indigolemon/EZ-FD/README.md

# EZ-FD
Allow standard PC floppy drives to be used with an Amiga

A small PCB designed to sit between the Amiga motherboard and the floppy drive.
Based on the same idea as the EZ-DF0 that was sold by Eyetech many years ago.

Testing shows it works well, though ATK shows a fluctuating RDY signal.
