indigolemon/EZ-FD/EZ-FD_Raytraced.png

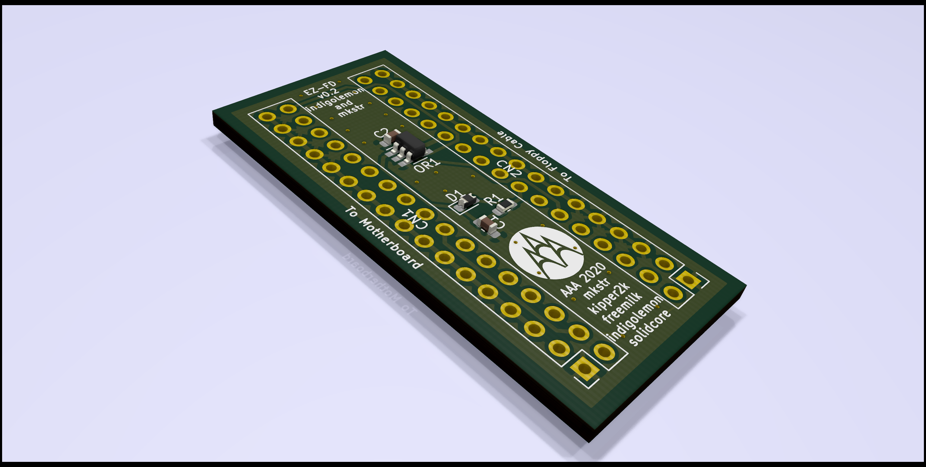
EZ-FD_Raytraced.png
