indigolemon/EZ-FD/EZ-FD.kicad_pcb

## KiCad design EZ-FD.kicad_pcb (2022-02-10)

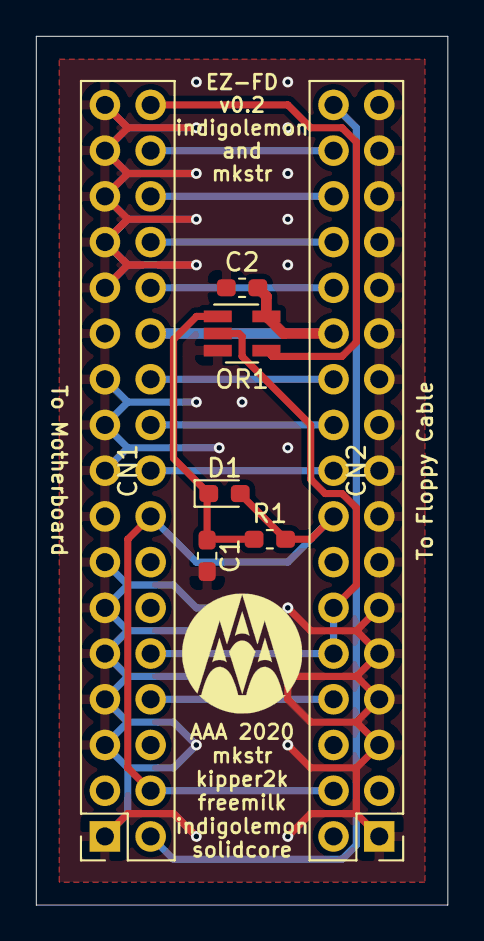
[picture p2: board EZ-FD.kicad_pcb from above]

Board: 2 copper layers, 22.9 x 48.3 mm, 7 parts (0 on the bottom side), 15 nets.

Parts:
C1: CP4.7u; C_0603_1608Metric_Pad1.05x0.95mm_HandSolder
C2: C100n; C_0603_1608Metric_Pad1.05x0.95mm_HandSolder
CN1: Amiga Floppy Port; PinHeader_2x17_P2.54mm_Vertical
CN2: FDD Cable; PinHeader_2x17_P2.54mm_Vertical
D1: 1N4148; D_0603_1608Metric_Pad1.05x0.95mm_HandSolder
OR1: 74LVC1G32; SOT-23-5_HandSoldering
R1: R115K; R_0603_1608Metric_Pad1.05x0.95mm_HandSolder

Connections:
GND: C1.2, C2.1, CN1.1, CN1.5, CN1.7, CN1.9, CN1.11, CN1.13, CN1.15, CN1.17, CN1.19, CN1.21, CN1.23, CN1.25, CN1.27, CN1.29, CN1.31, CN1.33, CN2.1, CN2.5, CN2.7, CN2.9, CN2.11, CN2.13, CN2.15, CN2.17, CN2.19, CN2.21, CN2.23, CN2.25, CN2.27, CN2.29, CN2.31, CN2.33, OR1.3
unnamed: C1.1, D1.1, OR1.1, R1.1
unnamed: CN1.2, CN2.34
unnamed: CN1.8, CN2.8
unnamed: CN1.10, CN2.10, CN2.12, OR1.2
unnamed: CN1.4, CN1.16, CN2.4, CN2.16, D1.2, R1.2
unnamed: CN1.18, CN2.18
unnamed: CN1.20, CN2.20
unnamed: CN1.22, CN2.22
unnamed: CN1.26, CN2.26
unnamed: CN1.28, CN2.28
unnamed: CN1.30, CN2.30
unnamed: CN1.32, CN2.32
unnamed: CN1.34, OR1.4
VCC: C2.2, CN1.24, CN2.24, OR1.5
