indigolemon/EZ-FD/(threads)

Thread 1 (2022-05-09):

Schematic

Kathleen1971, 2022-05-09:
Hi Dear,
It seems that I cannot open the schematic (maybe I missed something but every tentative I did where not successful) .
Could it be possible to upload the schematic in  .PDF format, will be easier anyway ? Despite that The circuit is quite simple, the issue is the 1N4148 where w/o having access to the schematic I cannot figure out how it needs to be placed. (cathode VS anode) Thanks !

Thread 2 (2022-12-19):

Amiga Floppy disk LED always on

ami-commo-fan, 2022-12-19:
I made one (rev 0.1) because gerbers seem not updated.
It works well, but the Floppy disk activity LED is always shining regardless if motor is spinning or not. Tested both on A500 and A1200.
Any clue?

indigolemon, 2022-12-19:
I'm really sorry, I only use it in a towered setup where I rely on the light on the srive itself - I assume its the light on the Amiga itself that stays on?

ami-commo-fan, 2022-12-20:
Yes, exactly, the Amiga drive LED stays on. I was reading elsewhere that the LED stays on when _mtr0 signal is active low.
Looking at the schematics I see the motor on is paired with pin4 (_inuse) which I am not sure why.
