indigolemon/EZ-FD/(commit log)

2022-02-10 Initial commit of all project files
    [EZ-FD-B_Mask.gbr, EZ-FD-B_SilkS.gbr, EZ-FD-Back.gbr, EZ-FD-Edge_Cuts.gbr, EZ-FD-F_Mask.gbr, EZ-FD-F_SilkS.gbr, EZ-FD-Front.gbr, EZ-FD-NPTH.drl]
2022-02-10 Cleaned up BOM, removed redundant backup zip
